oujianxiaobaobei/oujianxiaobaobe/README.md

# 藕尖小宝贝

> CRTC2026 参赛队伍文档仓库

## 队伍简介

- **队伍名称**：藕尖小宝贝（拼音 oujianxiaobaobei）
- **实训战队**：陵龙
- **队长**：陈伯旭

## 成员分工

| 成员 | 角色 |
|---|---|
| 陈伯旭 | 队长 / 机械 |
| 徐煜杰 | 机械 |
| 黄俊杰 | 电控 / 硬件 / 操作手 |
| 曹翱 | 电控 / 硬件 / 操作手 |

## 机器人概述

- **1 号机**：（待补充，如"守高台 / 抢核心"）
- **2 号机**：（待补充，如"上高台 / 收集方块"）

核心实现：
- 采用**抬升机结构**，实现方块**串取抬升**携带方式
- **PS2 手柄**控制四轮转动
- 整车**尺寸、重量合规**

## 文档目录索引

所有文档按机器人设计进度从早到晚组织，统一放在 [`docs/`](./docs/) 目录下。

| 文档 | 说明 |
|---|---|
| [00-学习日志](./docs/00-学习日志/) | 培训所学知识记录 |
| [01-方案构思与选型](./docs/01-方案构思与选型.md) | 候选方案对比、分工、预算 |
| [02-底盘搭建](./docs/02-底盘搭建.md) | 底盘搭建 |
| [03-基础运动控制](./docs/03-基础运动控制.md) | 基础运动控制 |
| [04-方块收集机构](./docs/04-方块收集机构.md) | 方块串取抬升机构 |
| [05-机电联调与迭代](./docs/05-机电联调与迭代.md) | 机电联调与迭代 |
| [99-开源项目说明](./docs/99-开源项目说明.md) | 开源项目完整说明 |

## 目录结构

```
.
├── README.md
├── docs/                 # ★ 手册要求：所有文档
│   ├── 00-学习日志/
│   ├── 01-方案构思与选型.md
│   ├── 02-底盘搭建.md
│   ├── 03-基础运动控制.md
│   ├── 04-方块收集机构.md
│   ├── 05-机电联调与迭代.md
│   └── 99-开源项目说明.md
├── hardware/             # 机械资料
│   ├── cad/
│   ├── drawings/
│   └── photos/
├── firmware/             # 电控代码
│   ├── robot1/
│   └── robot2/
├── assets/               # 文档图片
│   └── docs-img/
└── CHANGELOG.md
```

## 演示视频

（待补充演示视频链接）
