oujianxiaobaobei/oujianxiaobaobe/docs/01-方案构思与选型.md

# 01 方案构思与选型

> 记录时间：第一周（熟悉工作软件阶段）

## 项目目标

CRTC2026 比赛要求机器人完成方块（30mm 立方体）的收集与搬运任务。我们在备赛初期先明确了两台机器的分工与整体技术路线，再进行具体的机构与电控选型。

## 收集方块机构选型

方块收集的核心动作是"抓取 → 携带 → 释放"。在构思阶段，我们主要对比了**夹爪式**与**叉车式**两种候选方案：

| 候选方案 | 优势 | 劣势 | 结论 |
|---|---|---|---|
| 夹爪式 | 对单个方块定位精准 | 结构复杂但无实质效果提升，方块易打滑；还需额外储物盒、旋转盘，储存操作复杂 | 淘汰 |
| **叉车式（长圆柱长臂）** | **结构简单、携带快速** | 需要控制长臂倾斜角度与长度 | **最终采用** |

**为什么选叉车式长臂结构**：我们最终采用类似叉车的长圆柱结构，通过**一个电机驱动长臂倾斜**即可轻松、快速地完成方块的携带。而淘汰机械爪（夹爪）的主要原因是：夹爪结构复杂却对效果没有实质提升，反而容易打滑；同时夹爪方案还需要额外设计储物盒和旋转舵盘，配合电机驱动，导致储存操作复杂、零件数量多、装配和调试成本高。相比之下，长臂方案只用单个电机即可实现携带，简洁可靠。

## 底盘选型

底盘采用**麦克纳姆轮 + PS2 手柄控制**，实现灵活的全向移动。

- **为什么选麦轮**：麦克纳姆轮转向更轻松，能实现平移、原地自旋等普通轮/舵轮难以完成的动作，在抢方块、对位时更灵活。
- **控制**：PS2 手柄通过无线方式控制四轮转动。

## 尺寸与重量合规规划

整车尺寸需满足手册约束（初始 ≤290×195×210mm，展开 ≤445×400×450mm 或满足 550mm 球体规则）。

- **最卡手的约束是长度**：我们通过**控制长臂的长度**以及**联轴的摆放位置**，保证整车展开后长度不超限。
- 机架采用 3D 打印轻量化设计，控制整车重量在预算内。

## 机架材料选型

- **工艺**：采用 **3D 打印**。
- **原因**：成本较低、质量小、方便快捷，适合快速迭代。
- **材料**：选用 **PETG**，其强度足以应对比赛中的对抗与跌落场景，在强度与重量之间取得平衡。

## 预算规划

- **材料总花费**：350 元（符合新生组 ≤400 元预算约束，采购发票为准）。
- 材料清单详见采购记录。

## 团队分工

| 成员 | 分工 |
|---|---|
| 陈柏旭 | 队长 / 机械 |
| 徐煜杰 | 机械 |
| 黄俊杰 | 电控 / 硬件 / 操作手 |
| 曹翱 | 电控 / 硬件 / 操作手 |
