oujianxiaobaobei/oujianxiaobaobe/hardware/cad/README.md

# hardware/cad - 机械建模源文件

本目录存放机械组 SolidWorks 建模与 3D 打印切片文件，按零件迭代时间排列。

## 文件清单

### 大臂（收集机构核心零件）

| 文件 | 说明 |
|---|---|
| 藕尖小车的大臂.SLDPRT / .STEP | 初版大臂建模（10-13） |
| 藕尖的大臂第二版.SLDPRT | 大臂第二版（10-14） |
| 藕尖的大臂第二版3mf版本.3MF | 第二版切片文件 |
| 藕尖的大臂第二版111.3MF | 第二版再修正切片 |
| 藕尖的大臂第二版3mf版本_PLA_59m36s.gcode | 首次打印 gcode（PLA，59m36s） |
| 全新二合一大小臂.SLDPRT / .3MF | 大小臂合并方案（10-17，干涉重构） |
| 全新二合一大小臂有凹槽版.SLDPRT / .3MF | 增加电机凹槽版（关键迭代） |
| 全新二合一大小臂（打印版）.3MF | 打印用版本 |
| 全新二合一大小臂有凹槽版新新新版666打印用.3MF | 最终打印版本 |

### 挡板 / 小臂

| 文件 | 说明 |
|---|---|
| crtc挡板.SLDPRT / .step / .3MF | 挡板两版迭代 |
| crtc小臂 3mf版本.3mf | 小臂改进版（10-16） |

### 底盘 / 联轴 / 底座

| 文件 | 说明 |
|---|---|
| 底盘10月17号版本（打印）.3MF | 底盘打印版（10-17） |
| 底盘非打印版本（666）.3MF | 底盘非打印版 |
| crtc仓库.SLDPRT / .step | 整车装配文件 |
| crtc仓库编辑版.SLDPRT | 装配编辑版 |
| crtc仓库编辑版1017号（打印）.3mf | 装配 1017 打印版 |
| 旋转用底座.SLDPRT | 旋转底座方案（10-16，后弃用） |
| 联轴123456.SLDPRT | 联轴建模版 |
| 联轴123456(打印).SLDPRT / .3mf | 联轴打印版（10-17~18，底部螺纹孔与底盘连接） |
