oujianxiaobaobei/oujianxiaobaobe/docs/04-方块收集机构.md

# 04 方块收集机构

> 对应时间：第三～四周（采购、写代码调参、组装实操阶段）

## 方块收集机构（长臂叉车式）

### 功能描述

实现方块的收集与携带。采用**类似叉车的长圆柱长臂结构**，通过**一个电机驱动长臂倾斜**，将方块串到长臂上完成携带，搬运到目标位置后释放。

### 为什么选"长臂叉车式"

方块收集的核心矛盾在于：**结构复杂度 vs 携带可靠性**。我们主要对比了两种思路：

| 思路 | 结构复杂度 | 携带可靠性 | 结论 |
|---|---|---|---|
| 夹爪式（机械爪） | 高（需储物盒 + 旋转盘 + 多电机） | 低（易打滑） | 淘汰 |
| **长臂叉车式** | **低（单电机驱动长臂）** | **高（串取堆叠）** | **采用** |

**为什么淘汰夹爪**：夹爪结构复杂，却没有带来实质上的效果提升，反而容易打滑；此外夹爪方案还需要额外设计储物盒和旋转舵盘，并分别用电机驱动，储存操作复杂、零件数量多、装配调试成本高。

**为什么选长臂叉车式**：长圆柱长臂通过单个电机驱动倾斜，就能轻松、快速地串取并携带方块，结构简洁可靠，符合"用最少机构完成核心动作"的思路。

### 实现方案

- **长臂结构**：长圆柱长臂作为核心机构，负责串取与携带方块；
- **驱动方式**：单个电机驱动长臂倾斜，完成方块的串取与释放；
- **携带方式**：方块串在长臂上堆叠携带，稳定性好，一次可携带多个。

### 开发历程

1. **第二周**：完成长臂结构的建模，重点确定长臂长度与联轴摆放位置；
2. **第三周**：购买材料、编写控制代码、调参数，确定长臂倾斜动作的控制参数；
3. **第四周**：组装实操，完成方块串取携带的整机验证。

### 踩坑记录（结构干涉 → 方案重构）

这是本项目最重要的一次返工：

- **问题**：最初方案将收集机构分成了**大小臂 + 储物盒 + 旋转舵盘**，各部分分别用电机驱动。但由于**没有先做整车建模**，直接设计导致了严重的**结构干涉**。
- **发现**：装配阶段发现各部件互相碰撞、无法正常配合。
- **解决**：回归比赛规则中对"携带"的定义，反思"是否有必要做这么复杂的收纳结构"，最终决定**砍掉大小臂、储物盒和旋转舵盘，直接用一根长臂把方块串到一起**，大幅简化了结构，也彻底消除了干涉。

### 装配问题

- 由于公差及测量螺丝孔位存在误差，导致**铜柱无法在竖直状态下支撑**对应部件。
- 解决方案：让**铜柱略微倾斜**，即可完成连接并提供支撑，同时不影响整体强度。

### 最终实现

- 长臂叉车式结构实现方块串取携带；
- 与底盘、电控联调完成，单电机驱动即可完成携带动作。

### 迭代记录

各零件多版修改：

1. **长臂（大臂）**：修改了连接电机的凹槽设计及长臂长度，改善电机配合与携带范围；
2. **第二层支撑架**：去除了中间原本计划安放电机的空位槽，并增加与联轴连接的螺丝孔，使支撑更稳固、装配更可靠。

**迭代证据图**：

第一版零件（小臂 + 挡板 + 第二层支架）——后被简化方案替代：

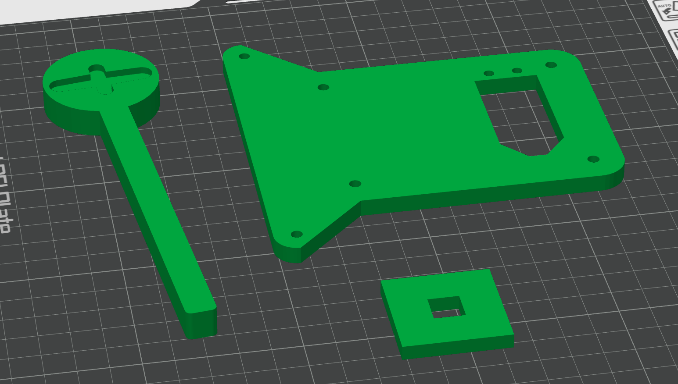
[picture p2: assets/docs-img/fusion-03-第一版零件切片.png]
第一版零件


被淘汰的储物盒方案（结构干涉的根源之一）：

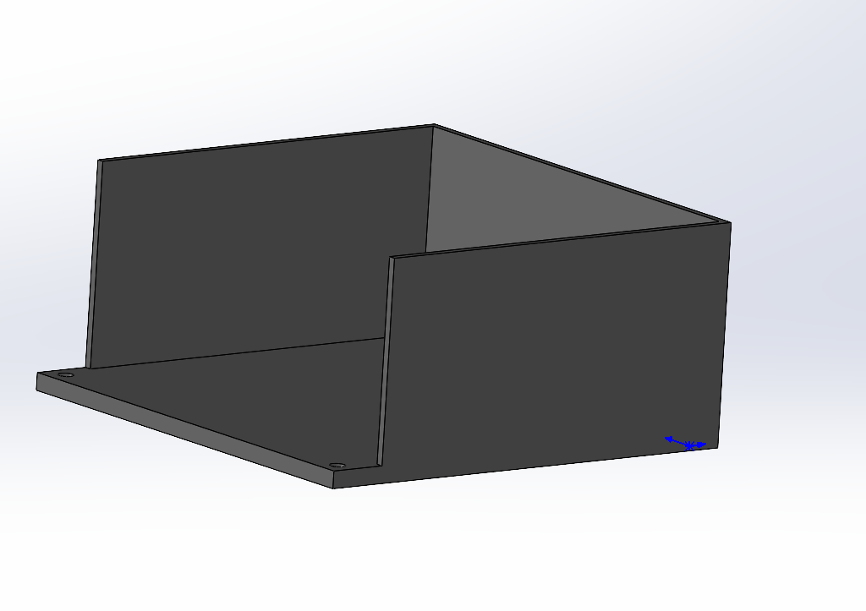
[picture p3: assets/docs-img/fusion-04-储物盒方案-淘汰.png]
储物盒方案-淘汰


最终采用的长臂（带电机安装孔，草图→实体建模）：

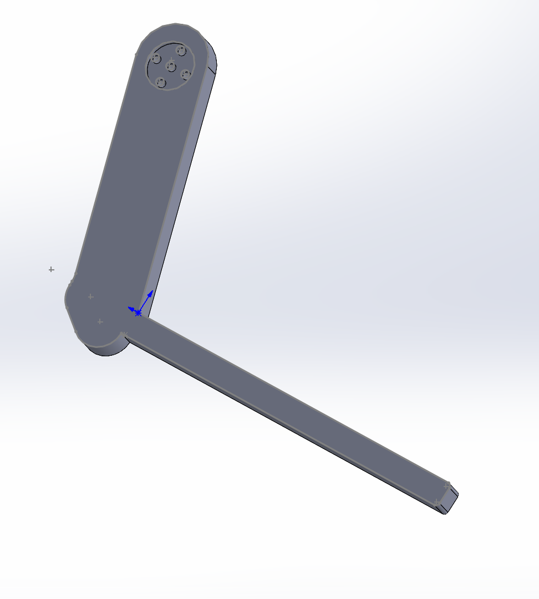
[picture p4: assets/docs-img/fusion-05-最终长臂.png]
最终长臂


修改后的第二层支撑架（已去除中间电机空位槽）：

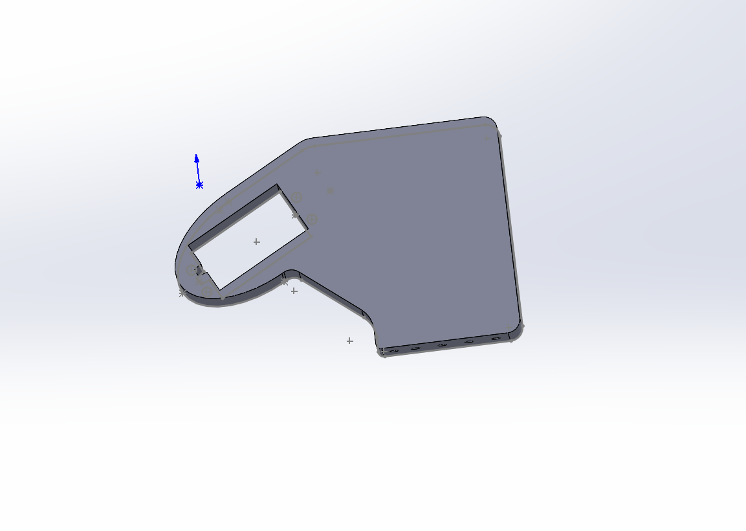
[picture p5: assets/docs-img/fusion-06-第二层支撑架-修改后.png]
第二层支撑架-修改后


### 效果验证

- 长臂单电机驱动即可完成方块串取携带；
- 建模图与迭代零件图见上，完整展示了"储物盒方案 → 干涉 → 简化为长臂"的全过程。
