oujianxiaobaobei/oujianxiaobaobe/hardware/cad/全新二合一大小臂有凹槽版.SLDPRT

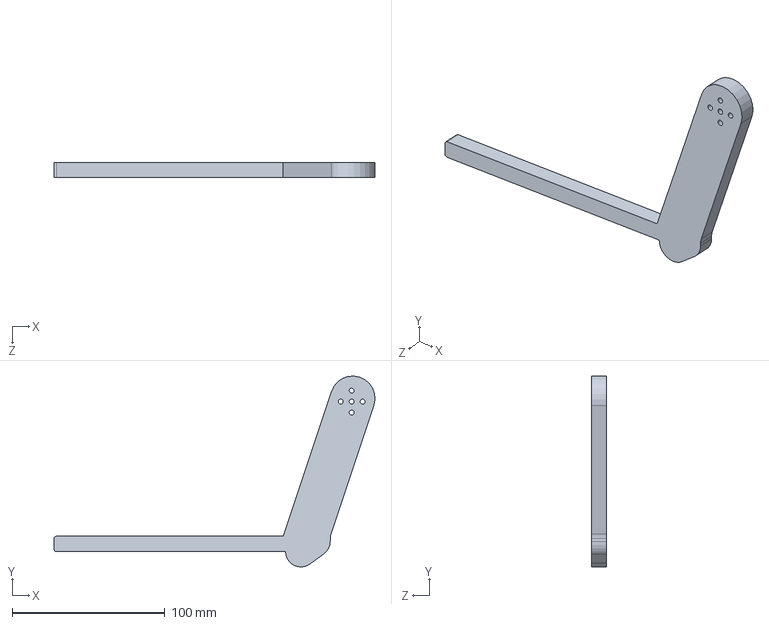
[picture p6: CAD file, 2026-10-19]
hardware/cad/全新二合一大小臂有凹槽版.SLDPRT
210.1 x 124.9 x 10.0 mm
