oujianxiaobaobei/oujianxiaobaobe/hardware/cad/crtc仓库.step

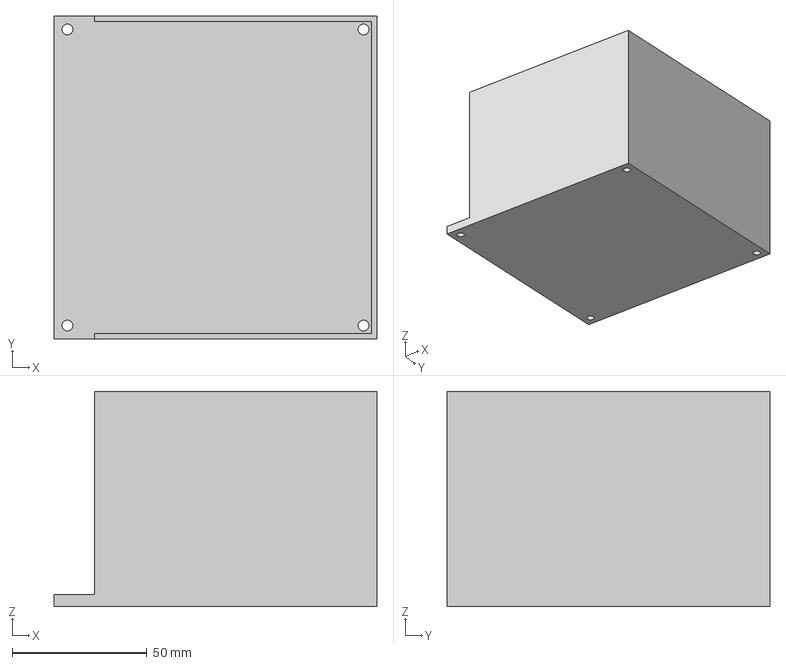
[picture p7: CAD file, 2026-10-19]
hardware/cad/crtc仓库.step
120.0 x 120.0 x 80.0 mm
