oujianxiaobaobei/oujianxiaobaobe/hardware/cad/底盘10月17号版本（打印）.3MF

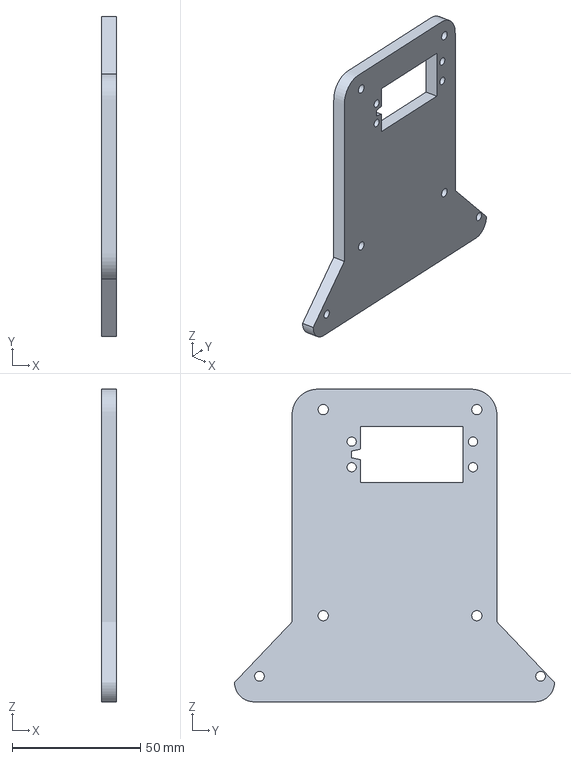
[picture p8: CAD file, 2026-10-19]
hardware/cad/底盘10月17号版本（打印）.3MF
6.00 x 125.0 x 122.2 mm
