oujianxiaobaobei/oujianxiaobaobe/hardware/cad/联轴123456(打印).SLDPRT

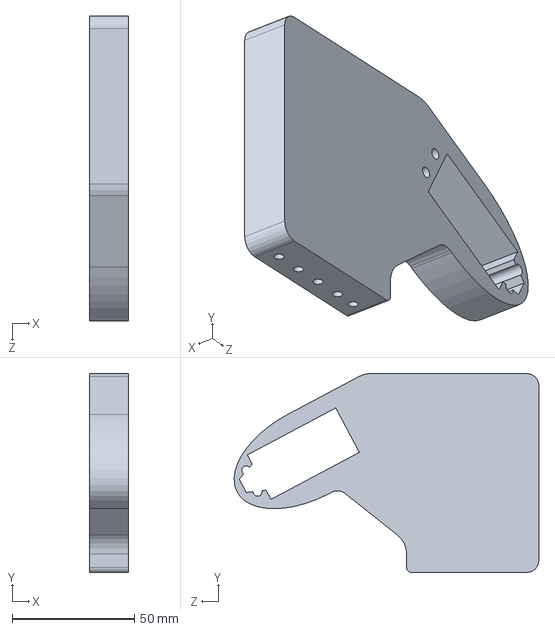
[picture p9: CAD file, 2026-10-19]
hardware/cad/联轴123456(打印).SLDPRT
16.0 x 81.5 x 124.8 mm
