oujianxiaobaobei/oujianxiaobaobe/hardware/cad/藕尖的大臂第二版3mf版本.3MF

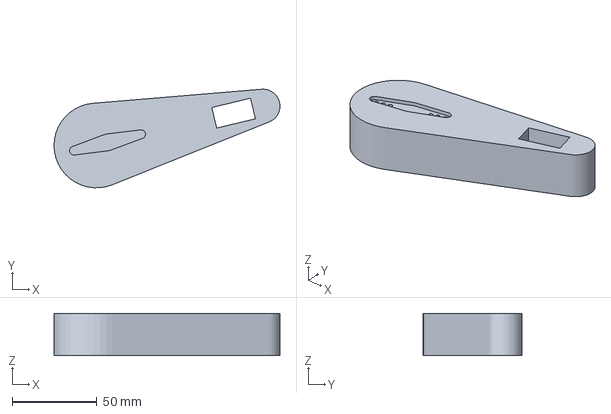
[picture p10: CAD file, 2026-10-19]
hardware/cad/藕尖的大臂第二版3mf版本.3MF
133.4 x 58.2 x 25.0 mm
