oujianxiaobaobei/oujianxiaobaobe/hardware/cad/crtc仓库编辑版1017号（打印）.3mf

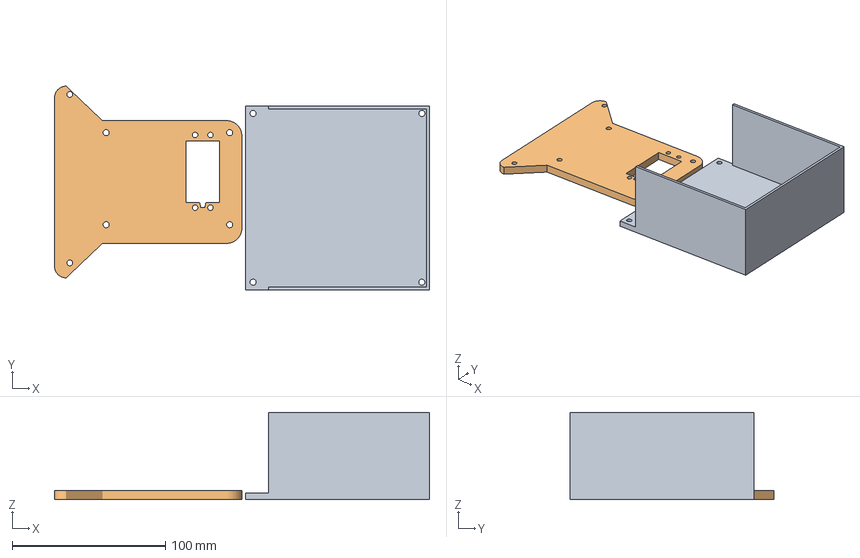
[picture p11: CAD file, 2026-10-19]
hardware/cad/crtc仓库编辑版1017号（打印）.3mf
244.4 x 132.8 x 57.0 mm
crtc仓库编辑版1017号（打印）
底盘10月17号版本（打印）
