oujianxiaobaobei/oujianxiaobaobe/hardware/cad/crtc小臂 3mf版本.3mf

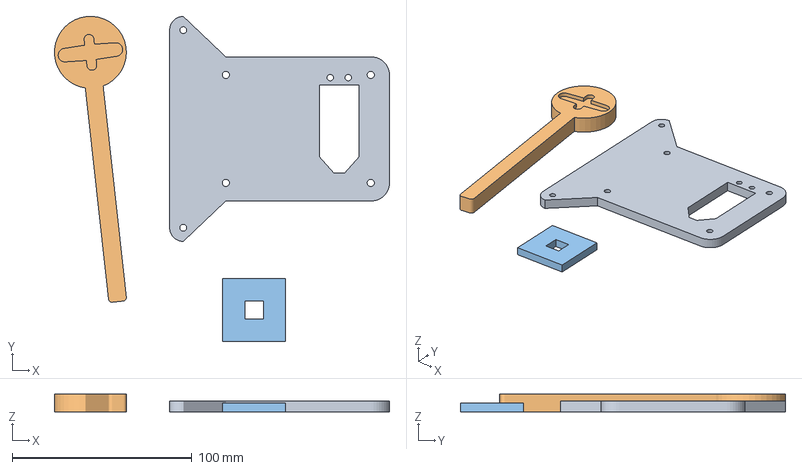
[picture p12: CAD file, 2026-10-19]
hardware/cad/crtc小臂 3mf版本.3mf
186.1 x 180.7 x 10.0 mm
底板
crtc小臂 3mf版本
crtc挡板
