oujianxiaobaobei/oujianxiaobaobe/hardware/cad/crtc挡板.step

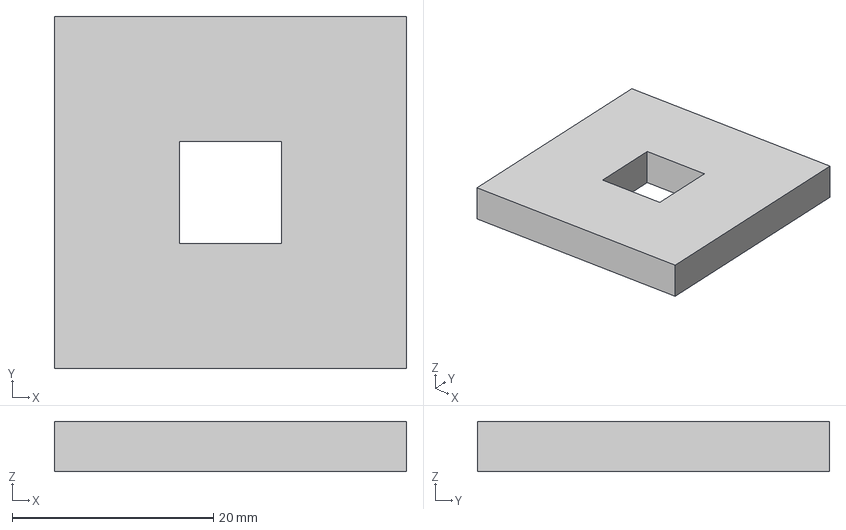
[picture p13: CAD file, 2026-10-19]
hardware/cad/crtc挡板.step
35.0 x 35.0 x 5.00 mm
