oujianxiaobaobei/oujianxiaobaobe/hardware/cad/全新二合一大小臂（打印版）.3MF

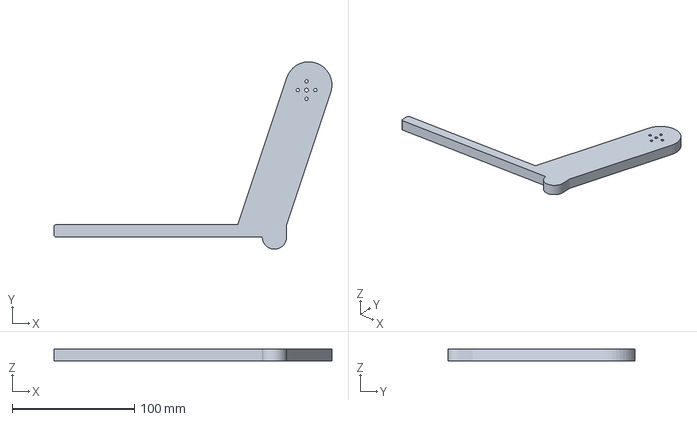
[picture p14: CAD file, 2026-10-19]
hardware/cad/全新二合一大小臂（打印版）.3MF
227.0 x 152.9 x 10.0 mm
