oujianxiaobaobei/oujianxiaobaobe/hardware/cad/crtc仓库编辑版.SLDPRT

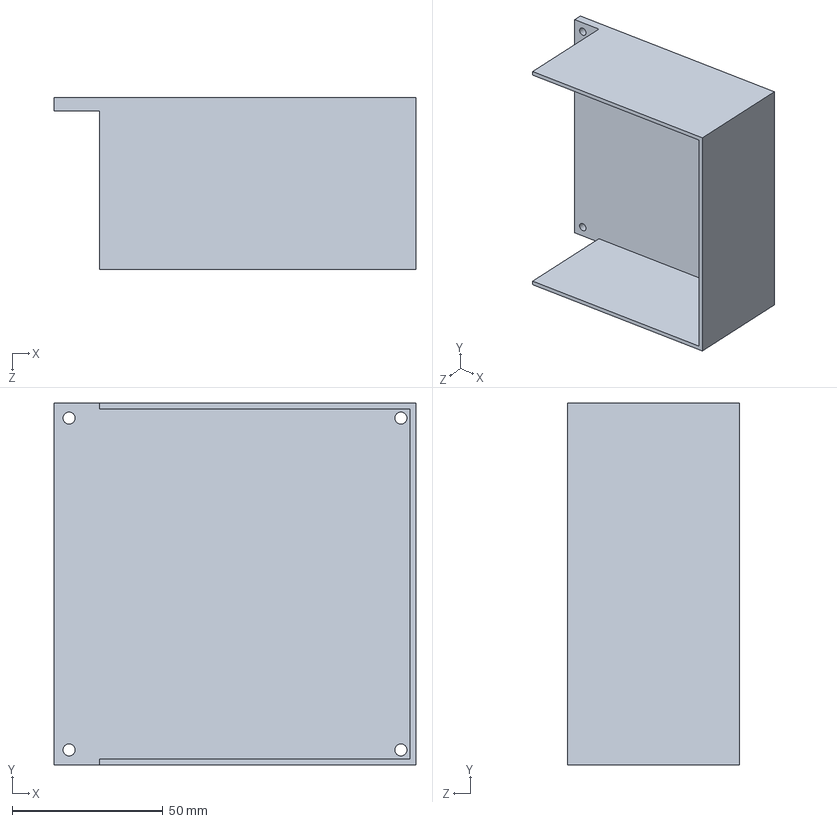
[picture p15: CAD file, 2026-10-19]
hardware/cad/crtc仓库编辑版.SLDPRT
120.0 x 120.0 x 57.0 mm
