oujianxiaobaobei/oujianxiaobaobe/hardware/cad/联轴123456.SLDPRT

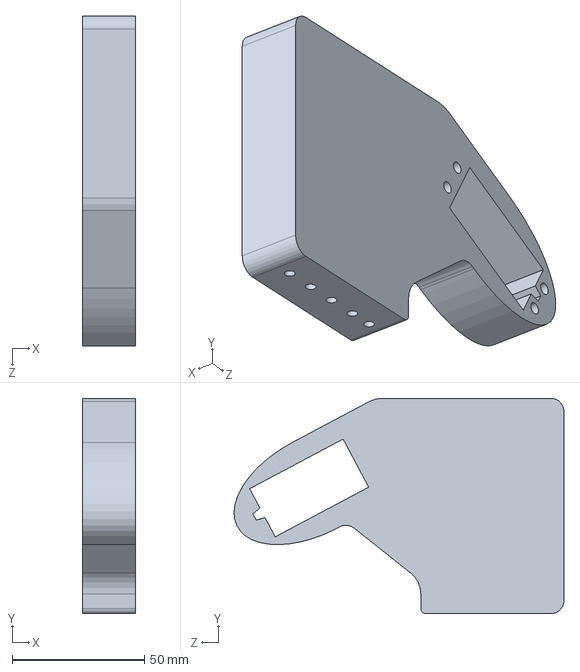
[picture p16: CAD file, 2026-10-19]
hardware/cad/联轴123456.SLDPRT
20.0 x 81.5 x 124.8 mm
