oujianxiaobaobei/oujianxiaobaobe/hardware/cad/藕尖小车的大臂.STEP

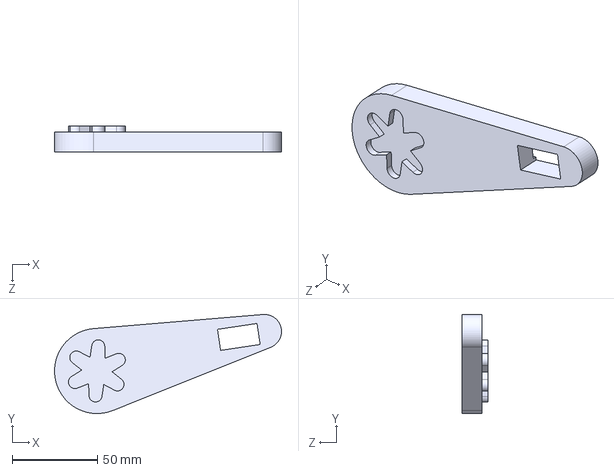
[picture p17: CAD file, 2026-10-19]
hardware/cad/藕尖小车的大臂.STEP
133.4 x 58.2 x 15.0 mm
