oujianxiaobaobei/oujianxiaobaobe/hardware/cad/藕尖的大臂第二版111.3MF

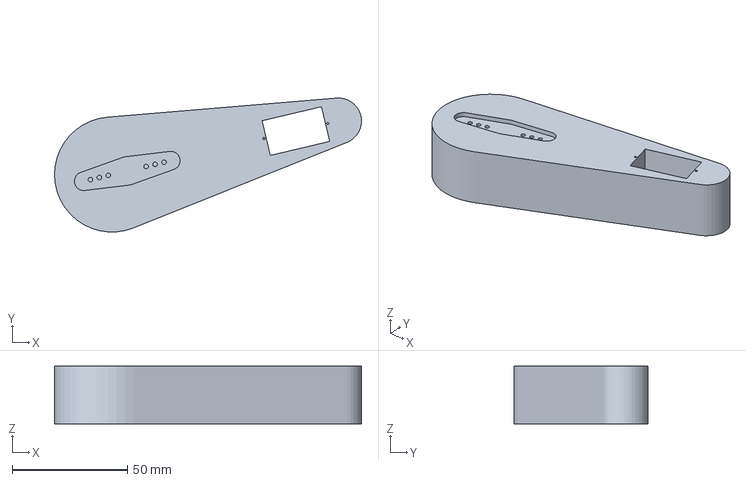
[picture p18: CAD file, 2026-10-19]
hardware/cad/藕尖的大臂第二版111.3MF
133.4 x 58.2 x 25.0 mm
