oujianxiaobaobei/oujianxiaobaobe/hardware/cad/底盘非打印版本（666）.3MF

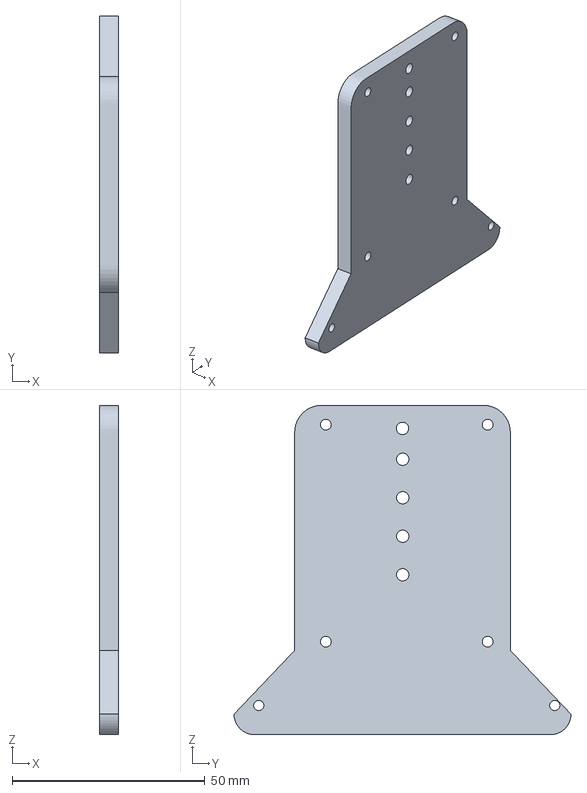
[picture p19: CAD file, 2026-10-19]
hardware/cad/底盘非打印版本（666）.3MF
5.00 x 87.5 x 85.5 mm
