oujianxiaobaobei/oujianxiaobaobe/(list of files, cad)

Other CAD files:
hardware/cad/全新二合一大小臂有凹槽版新新新版666打印用.3MF
hardware/cad/全新二合一大小臂.SLDPRT
hardware/cad/旋转用底座.SLDPRT
hardware/cad/藕尖的大臂第二版.SLDPRT
hardware/cad/联轴123456(打印)666.3mf
hardware/cad/crtc挡板.3MF
hardware/cad/全新二合一大小臂.3MF
hardware/cad/全新二合一大小臂有凹槽版.3MF
hardware/cad/藕尖小车的大臂.SLDPRT
