oujianxiaobaobei/oujianxiaobaobe/docs/00-学习日志/README.md

# 学习日志

培训所学知识记录（依据手册：记录学习到的知识内容）。

## 目录

- [01 机械 - Fusion360 与结构设计](./01-机械-Fusion360与结构设计.md)
- [02 电控 - GPIO / PWM 与电机舵机](./02-电控-GPIO-PWM与电机舵机.md)
- [03 电控 - FreeRTOS 与工程结构](./03-电控-FreeRTOS与工程结构.md)
- [04 电控 - SPI 与 PS2 手柄](./04-电控-SPI与PS2手柄.md)
- [05 电控 - 麦轮运动学解算](./05-电控-麦轮运动学解算.md)
