oujianxiaobaobei/oujianxiaobaobe/CHANGELOG.md

# 更新日志

整车迭代大事记时间线（按时间从早到晚）。

## 备赛时间线

| 阶段 | 时间 | 主要工作 |
|---|---|---|
| 第一周 | 熟悉工作软件 | 学习 Fusion360 等建模工具的基础操作 |
| 第二周 | 建模 + 3D 打印体验 | 底盘与抬升机结构建模，体验 3D 打印流程 |
| 第三周 | 购买材料 + 编写代码 | 采购材料（共 350 元），编写控制代码、调参数 |
| 第四周 | 组装实操 | 整机组装、机电联调、方块串取抬升功能验证 |

## 里程碑

- 完成底盘搭建（四轮 + PS2 手柄控制）
- 完成抬升机结构（方块串取抬升携带）
- 完成机电联调与整机验证
- 尺寸、重量合规
