oujianxiaobaobei/oujianxiaobaobe/(commit log)

2026-10-18 init: CRTC2026 参赛文档仓库骨架
2026-10-18 docs: 填充队伍信息与备赛时间线
2026-10-18 docs: 深化 04 方块收集机构（串取抬升原理与选型对比）
2026-10-18 docs: 添加装配与调试照片并嵌入 02/03 文档
2026-10-18 docs: 移除照片与图片引用，恢复纯文字版
2026-10-19 docs: 填充机械组素材（选型对比/踩坑/迭代/材料）
2026-10-19 docs: 填充电控组素材（选型/踩坑/调参/电源/开源声明/学习日志）
2026-10-19 docs: 添加机械组建模截图，删除 06 进阶功能
2026-10-19 docs: 05 补充零件迭代版本时间线截图
2026-10-19 docs: 归档机械组 CAD 源文件到 hardware/cad
    [crtc仓库.step, crtc仓库编辑版.SLDPRT, crtc仓库编辑版1017号（打印）.3mf, crtc小臂 3mf版本.3mf, crtc挡板.3MF, crtc挡板.step, 全新二合一大小臂.3MF, 全新二合一大小臂.SLDPRT]
